SteveMayze/TfaC/images/uC-DisplayIntegrationTest.png

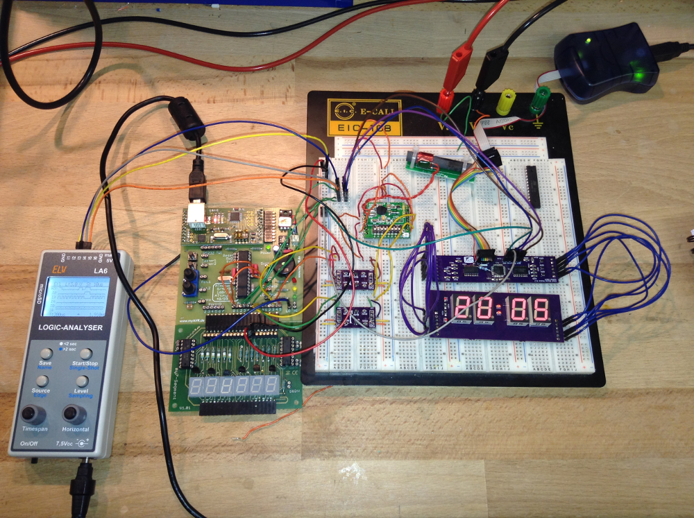
images/uC-DisplayIntegrationTest.png
