SteveMayze/TfaC/images/SystemTest-01b.JPG

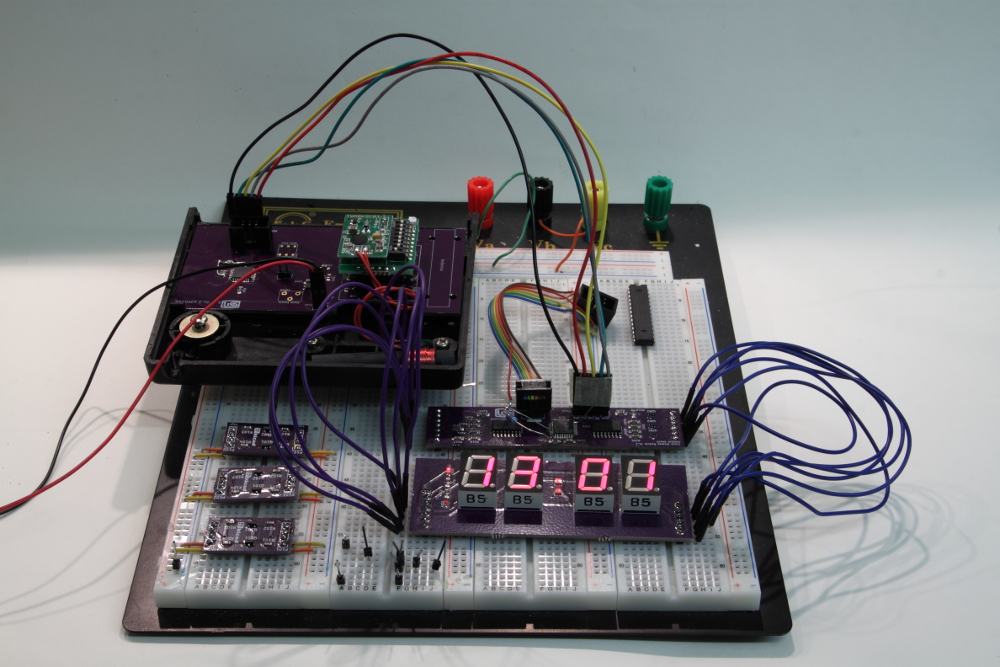
images/SystemTest-01b.JPG
