SteveMayze/TfaC/EA/image/Alarm Clock System State.png

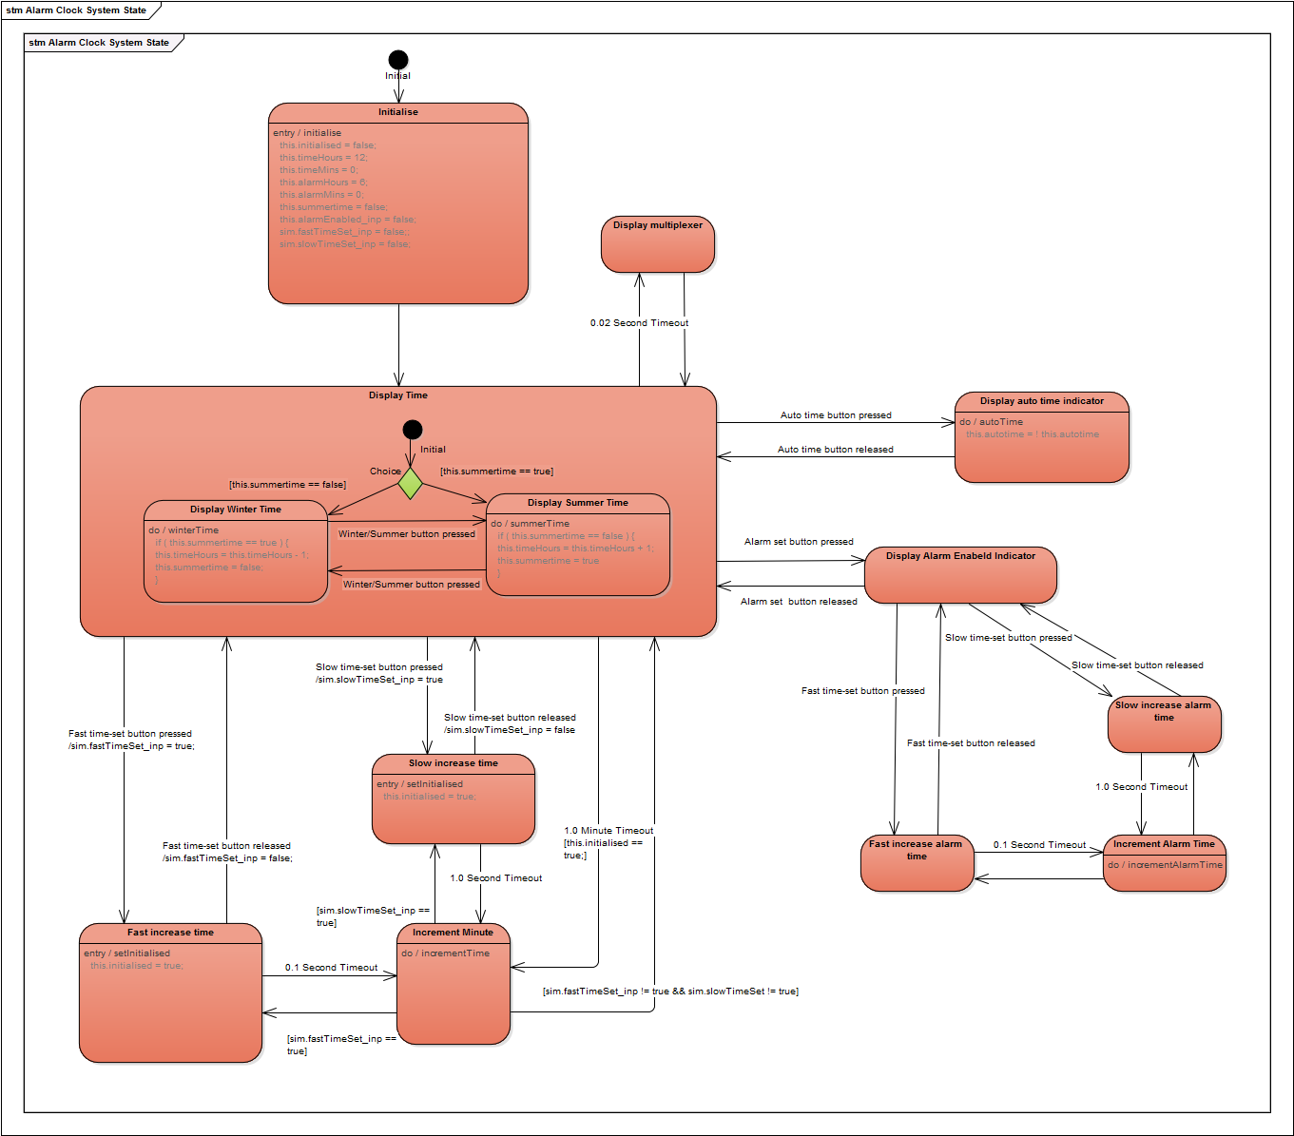
EA/image/Alarm Clock System State.png
