SteveMayze/TfaC/EA/image/Alarm Clock System.png

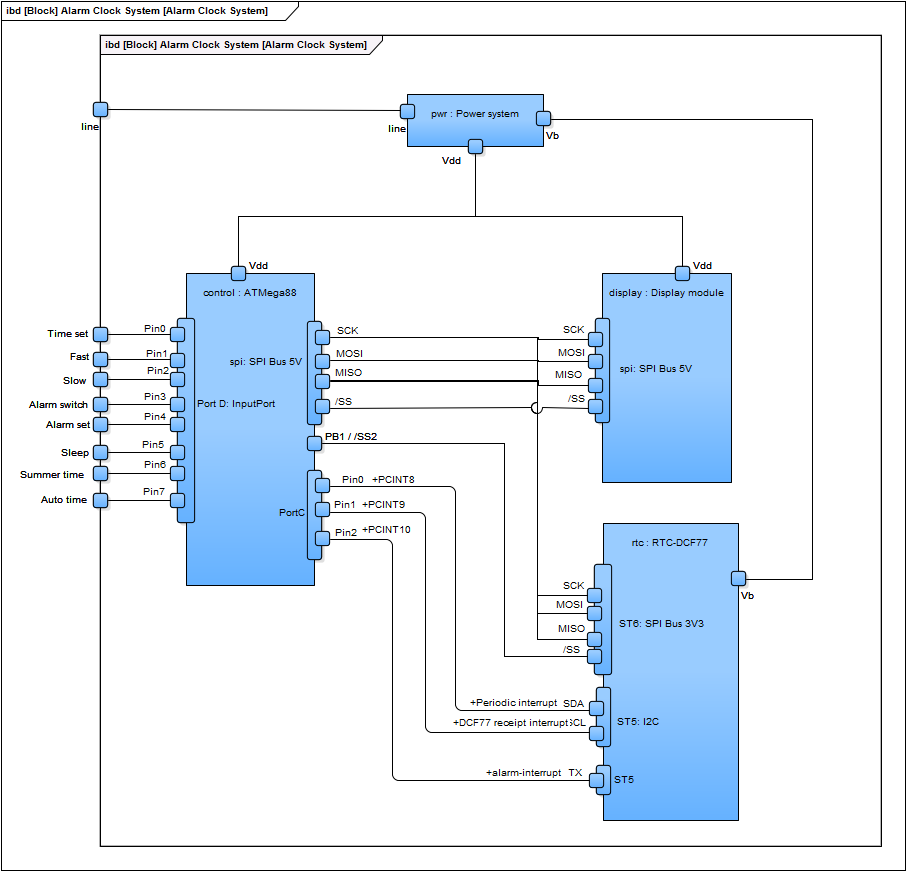
EA/image/Alarm Clock System.png
