SteveMayze/TfaC/EA/image/Display module - Controller.png

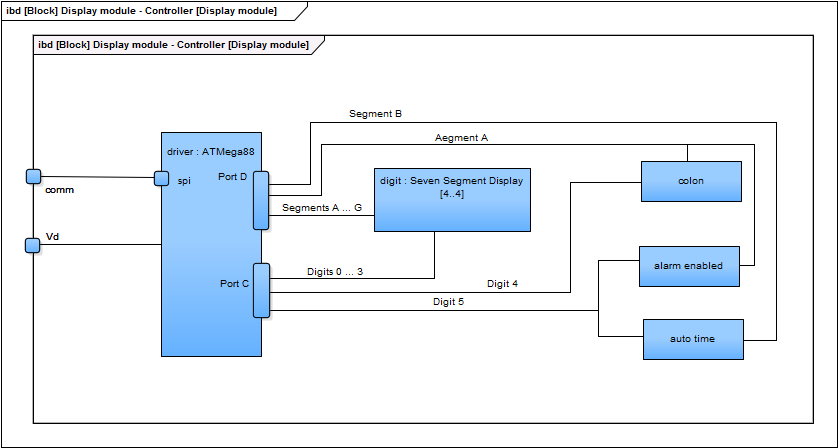
EA/image/Display module - Controller.png
