SteveMayze/TfaC/EA/image/Display module - Maxim.png

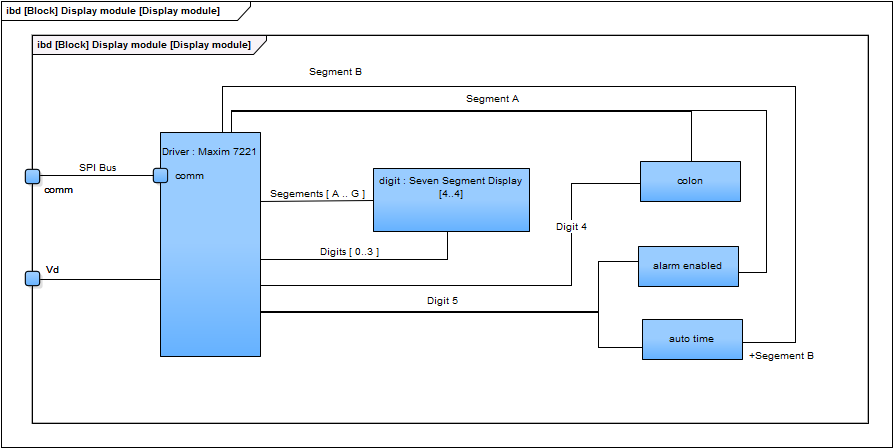
EA/image/Display module - Maxim.png
