SteveMayze/TfaC/EA/image/Project Package Model.png

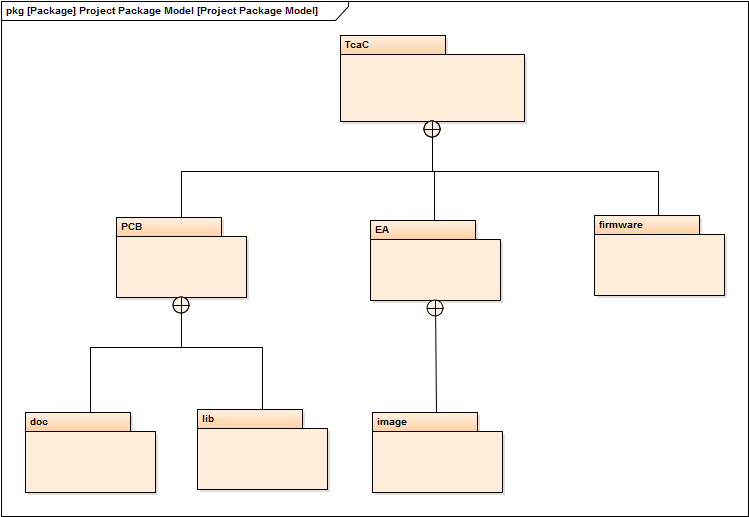
EA/image/Project Package Model.png
