SteveMayze/TfaC/EA/image/Specifications.png

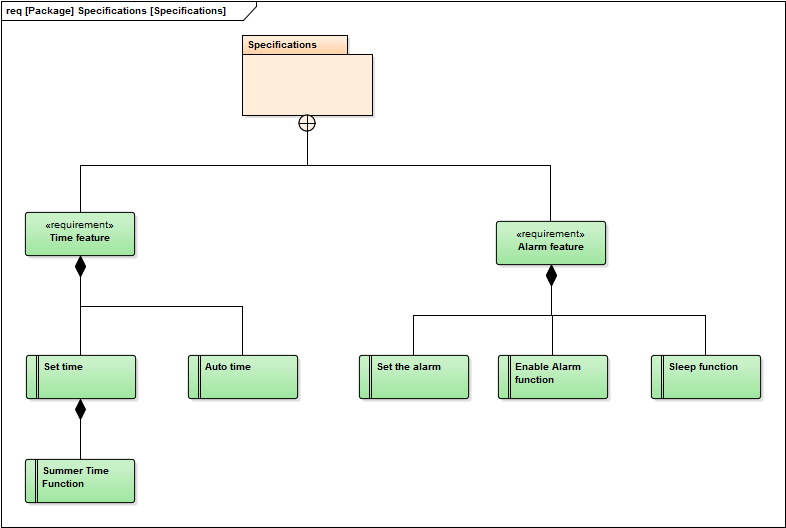
EA/image/Specifications.png
