SteveMayze/TfaC/images/ATMega88-PinOut.png

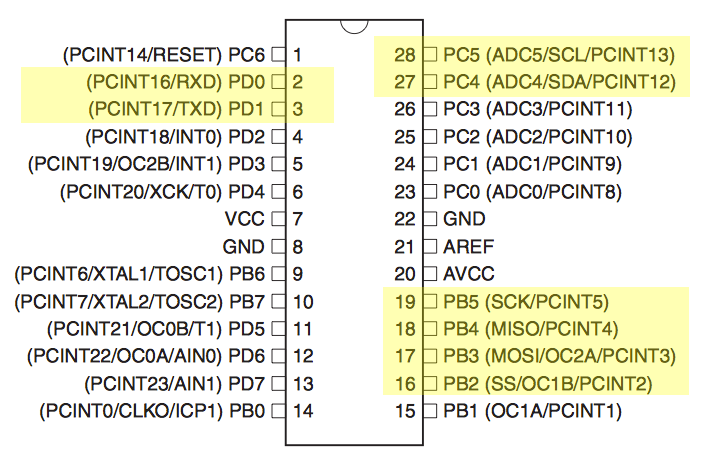
images/ATMega88-PinOut.png
