SteveMayze/TfaC/images/display-bank.png

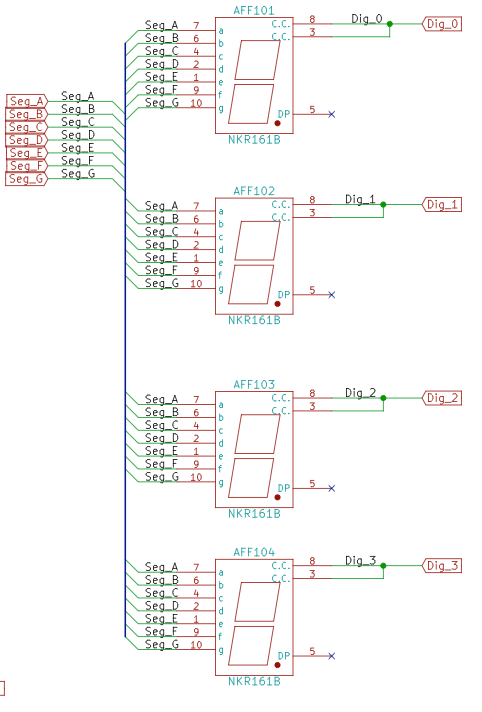
images/display-bank.png
