SteveMayze/TfaC/images/driver.png

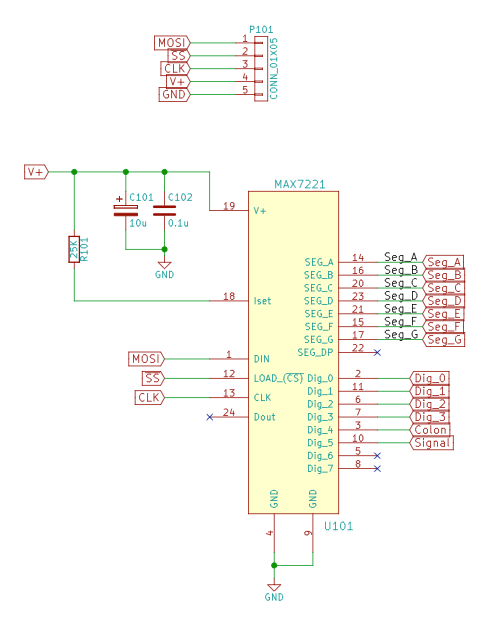
images/driver.png
