SteveMayze/TfaC/images/Heartbeat-Bodge-b.JPG

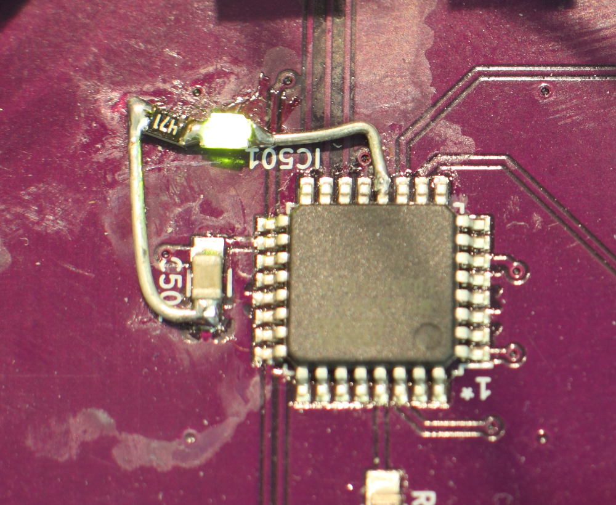
images/Heartbeat-Bodge-b.JPG
