SteveMayze/TfaC/images/indicators.png

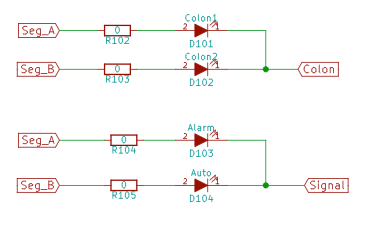
images/indicators.png
