SteveMayze/TfaC/images/Layout-4L.png

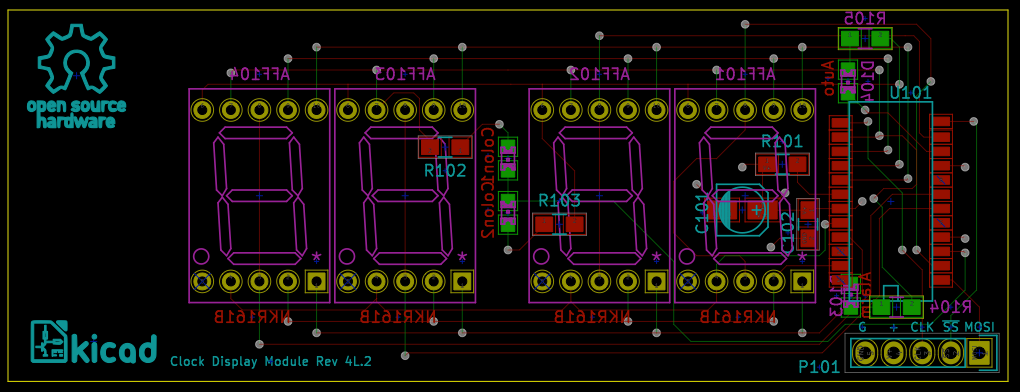
images/Layout-4L.png
