SteveMayze/TfaC/images/OHPart-Front.png

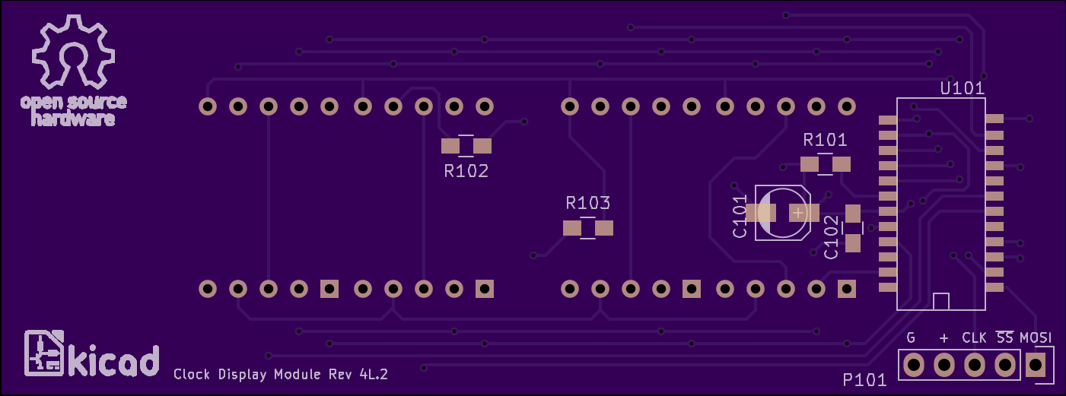
images/OHPart-Front.png
