SteveMayze/TfaC/images/OSHPark-Bottom.png

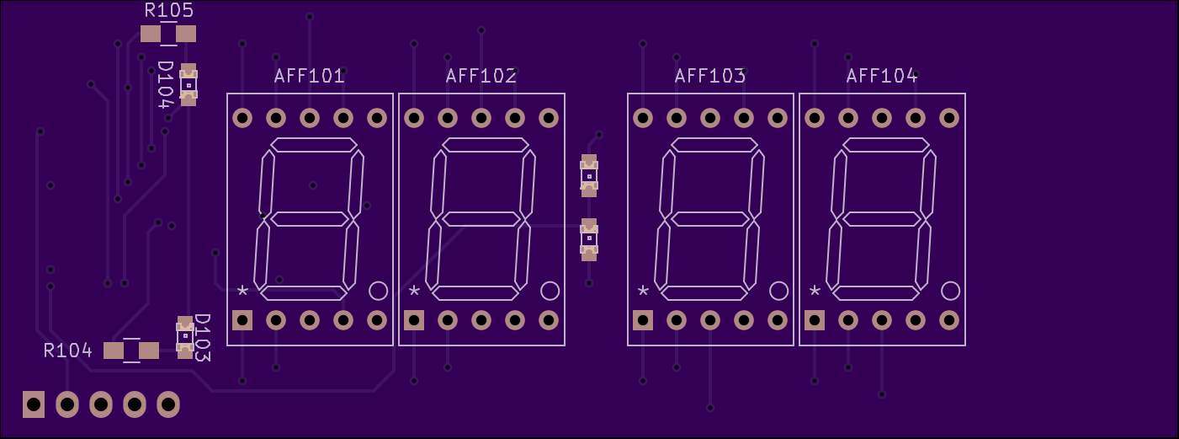
images/OSHPark-Bottom.png
