SteveMayze/TfaC/images/PanelledBoard.jpg

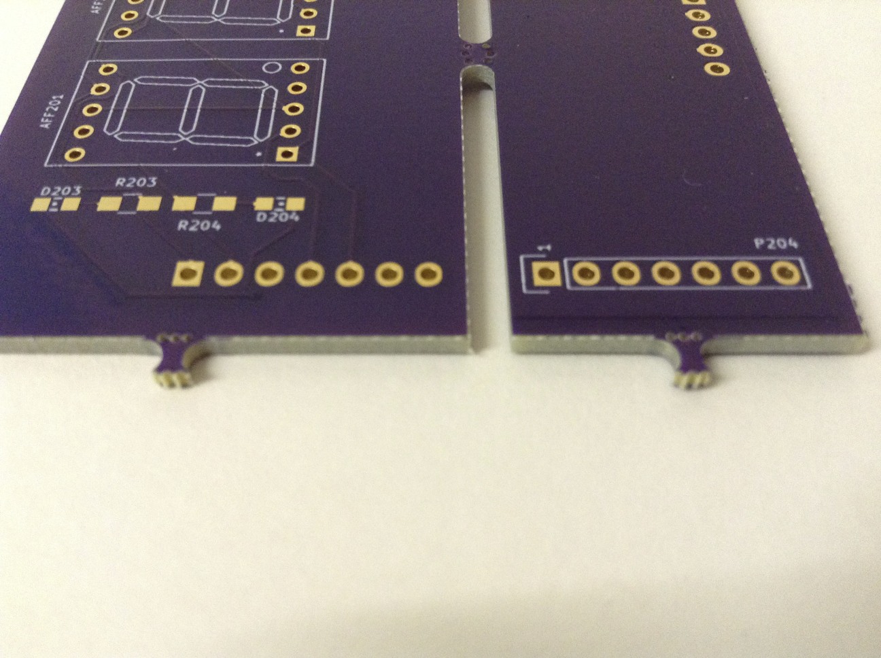
images/PanelledBoard.jpg
