SteveMayze/TfaC/images/SignalToDisplay.png

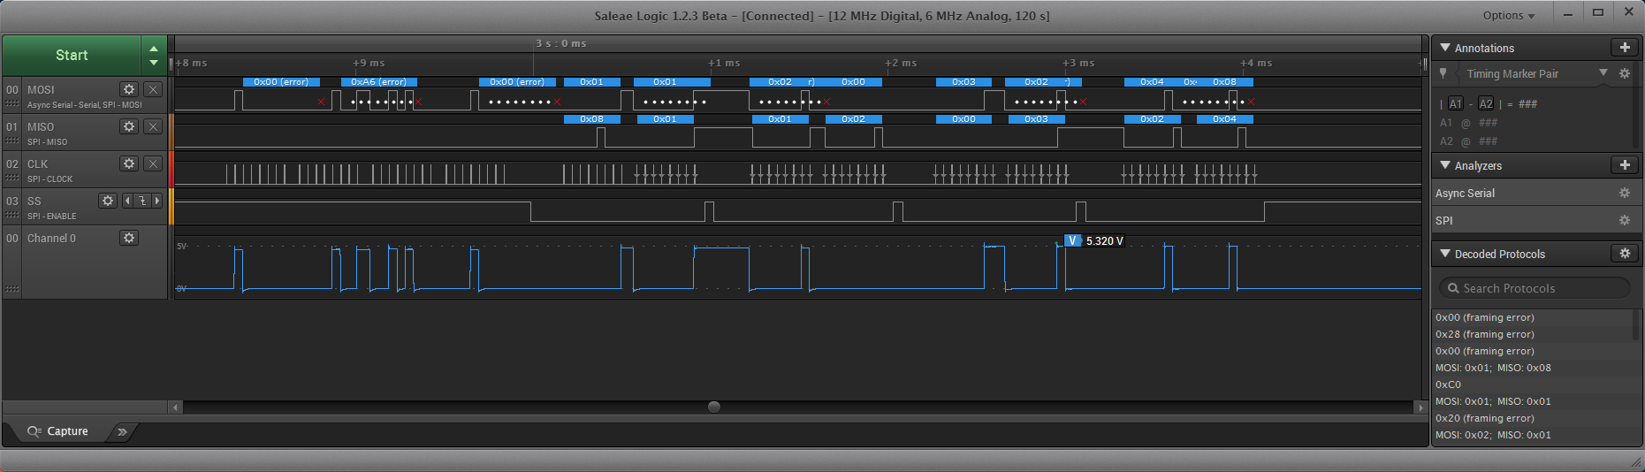
images/SignalToDisplay.png
