SteveMayze/TfaC/PCB/TfaC.ods

Sheet: Clock
Reference | Quantity | Value | Base Price | Tax | Net | Gross
C201, C202, C203, C204, | 4 | 1u | 0.03813684 | 19.00% | 0.045383 | 0.18
C501, | 1 | 100n | 0.03813684 | 19.00% | 0.045383 | 0.05
D201, D202, D501, | 3 | LED | 0.17140000 | 0.00% | 0.171400 | 0.51
D503, | 1 | 1N4148W | 0.05280000 | 19.00% | 0.062832 | 0.06
IC501, | 1 | ATMEGA88-A | 4.38000000 | 0.00% | 4.380000 | 4.38
M301, | 1 | DisplayModule | 35.13754009 | 0.00% | 35.137540 | 35.14
P101, | 1 | Line | 0.07540000 | 0.00% | 0.075400 | 0.08
P501, | 1 | PRG | 0.22620000 | 19.00% | 0.269178 | 0.27
Q401, Q402, Q403, Q404, Q405, Q406, Q408, | 7 | IRLML2502 | 0.15180000 | 19.00% | 0.180642 | 1.26
Q407, | 1 | NOPOP | 0.00000000 | 19.00% | 0.000000 | 0.00
Q501, | 1 | 2SD2391 | 0.52000000 | 19.00% | 0.618800 | 0.62
R201, | 1 | 0 | 0.02295946 | 19.00% | 0.027322 | 0.03
R202, R502, | 2 | 480Ohm | 0.02295946 | 19.00% | 0.027322 | 0.05
R203, | 1 | 260Ohm | 0.02295946 | 0.00% | 0.022959 | 0.02
R401, R403, R405, R407, R409, R411, R415, R501, | 8 | 10K | 0.02295946 | 0.00% | 0.022959 | 0.18
R402, R404, | 2 | 1K5 | 0.02295946 | 0.00% | 0.022959 | 0.05
R406, R408, R410, R412, R416, | 5 | 4K7 | 0.02295946 | 19.00% | 0.027322 | 0.14
R413, R414, | 2 | NOPOP | 0.00000000 | 0.00% | 0.000000 | 0.00
SP501, | 1 | CT-1205-SMT | 2.37000000 | 19.00% | 2.820300 | 2.82
SW501, | 1 | Time Set | 0.20800000 | 19.00% | 0.247520 | 0.25
SW502, | 1 | Alarm Set | 0.20800000 | 19.00% | 0.247520 | 0.25
SW503, | 1 | Fast | 0.20800000 | 19.00% | 0.247520 | 0.25
SW504, | 1 | Slow | 0.20800000 | 19.00% | 0.247520 | 0.25
SW505, | 1 | AUTO_TIME | 0.07540000 | 19.00% | 0.089726 | 0.09
SW506, | 1 | Sleep | 0.20800000 | 19.00% | 0.247520 | 0.25
SW507, | 1 | Summer Time | 0.07540000 | 19.00% | 0.089726 | 0.09
SW508, | 1 | Alarm Enabled | 0.82000000 | 19.00% | 0.975800 | 0.98
SW509, | 1 | Reset | 0.37700000 | 19.00% | 0.448630 | 0.45
U201, | 1 | MCP1703T-5002E/CB | 0.63000000 | 19.00% | 0.749700 | 0.75
U202, | 1 | LD2979 | 0.89000000 | 19.00% | 1.059100 | 1.06
U401, | 1 | RTC-DCF77 | 12.95000000 | 0.00% | 12.950000 | 12.95
W201, W202, | 2 | TEST_1P | 0.00000000 | 0.00% | 0.000000 | 0.00
Boards | 1 |  | 13.16000000 | 0.00% | 13.160000 | 13.16
 |  |  |  |  | COS | 76.60 €
 |  |  |  |  | Price | 229.80 €
 |  |  |  |  |  | 41.46 €

Sheet: Display
Reference | Quantity | Value | Footprint | DigiKeyPN | Base Price | Tax | Net | Gross
AFF201, AFF202, AFF203, AFF204, | 4 | NKR161B | ClockFootprints:161_163_Series_extended |  | 2.43000000 | 19.00% | 2.891700 | 11.57
C101, | 1 | 0.1u | Capacitors_SMD:C_0805 |  | 0.03813684 | 0.00% | 0.038137 | 0.04
D201, | 1 | Colon1 | LEDs:LED-0805 |  | 0.17140000 | 19.00% | 0.203966 | 0.20
D202, | 1 | Colon2 | LEDs:LED-0805 |  | 0.17140000 | 19.00% | 0.203966 | 0.20
D203, | 1 | Alarm | LEDs:LED-0805 |  | 0.17140000 | 19.00% | 0.203966 | 0.20
D204, | 1 | Auto | LEDs:LED-0805 |  | 0.17140000 | 19.00% | 0.203966 | 0.20
IC1, | 1 | ATMEGA88PA-A | Housings_QFP:LQFP-32_7x7mm_Pitch0.8mm |  | 4.38000000 | 0.00% | 4.380000 | 4.38
P101, | 1 | CONN_02X03 | Pin_Headers:Pin_Header_Straight_2x03 |  | 0.22620000 | 19.00% | 0.269178 | 0.27
P102, P202, P204, | 3 | CONN_01X07 | Pin_Headers:Pin_Header_Straight_1x07 | Value | 0.26390000 | 19.00% | 0.314041 | 0.94
P201, P203, | 2 | CONN_01X06 | Pin_Headers:Pin_Header_Straight_1x06 |  | 0.22620000 | 19.00% | 0.269178 | 0.54
Q201, Q202, Q203, | 3 | BC856BS | ClockFootprints:SOT-363 |  | 0.19640000 | 19.00% | 0.233716 | 0.70
R101, | 1 | 10K | Resistors_SMD:R_0805 |  | 0.02295946 | 0.00% | 0.022959 | 0.02
R102, R103, R104, R106, | 4 | 1K | Resistors_SMD:R_0805 |  | 0.02295946 | 0.00% | 0.022959 | 0.09
R105, R201, R202, R203, R204, | 5 | 0 | Resistors_SMD:R_0805 |  | 0.02295946 | 0.00% | 0.022959 | 0.11
R205, R206, R207, R208, R209, R210, | 6 | 500 | Resistors_SMD:R_0805 |  | 0.02295946 | 0.00% | 0.022959 | 0.14
R211, R212, R213, R214, R215, R216, R217, | 7 | 160 | Resistors_SMD:R_0805 |  | 0.02295946 | 0.00% | 0.022959 | 0.16
SW101, | 1 | TL3315NF160Q | ClockFootprints:PTS525SM15SMTR2LFS |  | 0.37700000 | 19.00% | 0.448630 | 0.45
U201, | 1 | SN74LS138 | ClockFootprints:SOIC-16 |  | 0.69600000 | 19.00% | 0.828240 | 0.83
U202, | 1 | 74HC4511 | ClockFootprints:SOIC-16 |  | 0.40700000 | 19.00% | 0.484330 | 0.48
Boards | 1 |  |  |  | 13.59666667 | 0.00% | 13.596667 | 13.60
 |  |  |  |  |  |  | COS | 35.14 €
 |  |  |  |  |  |  | Price | 105.41 €
