SteveMayze/TfaC/(list of files, cad)

Other CAD files:
Sketchup/ClockBody.skp
Sketchup/ClockBody~.skp
