SteveMayze/TfaC/Test/ClockWrong-TimeCorrect-2213-2053.png

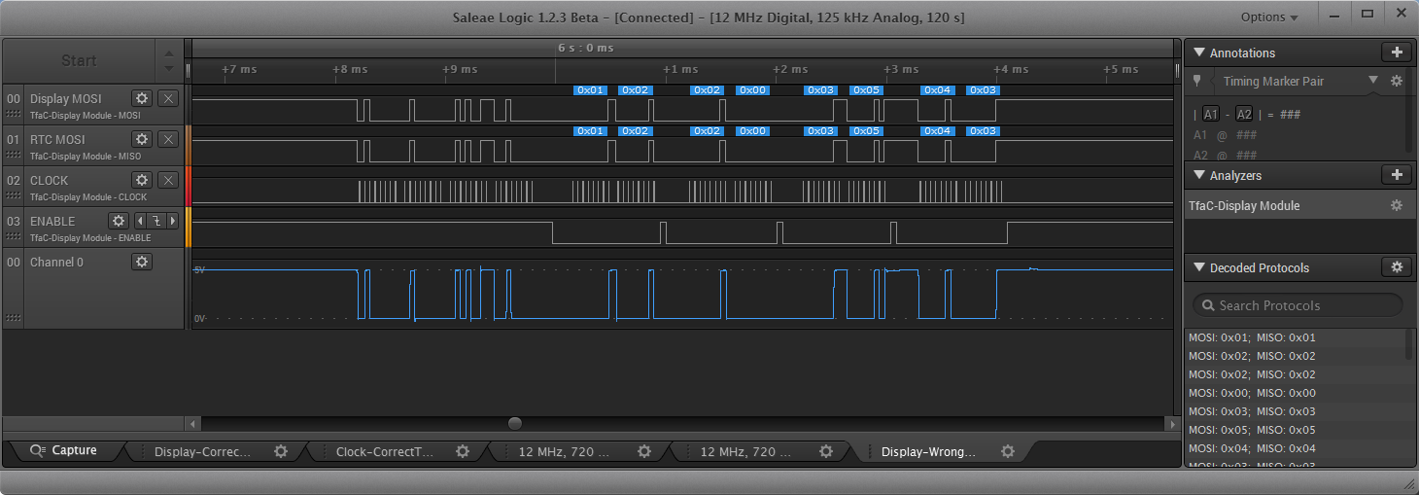
Test/ClockWrong-TimeCorrect-2213-2053.png
