SteveMayze/TfaC/Test/ClockWrong-TimeCorrect-3201-2105.png

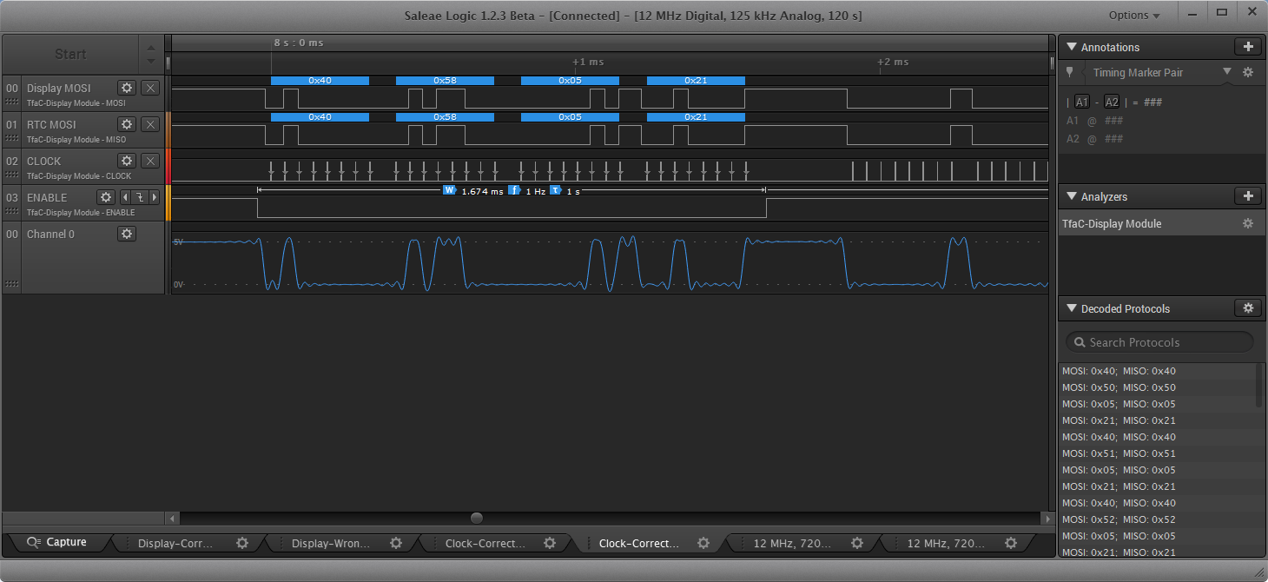
Test/ClockWrong-TimeCorrect-3201-2105.png
