SteveMayze/TfaC/Test/MOSI-Polarity-Change.png

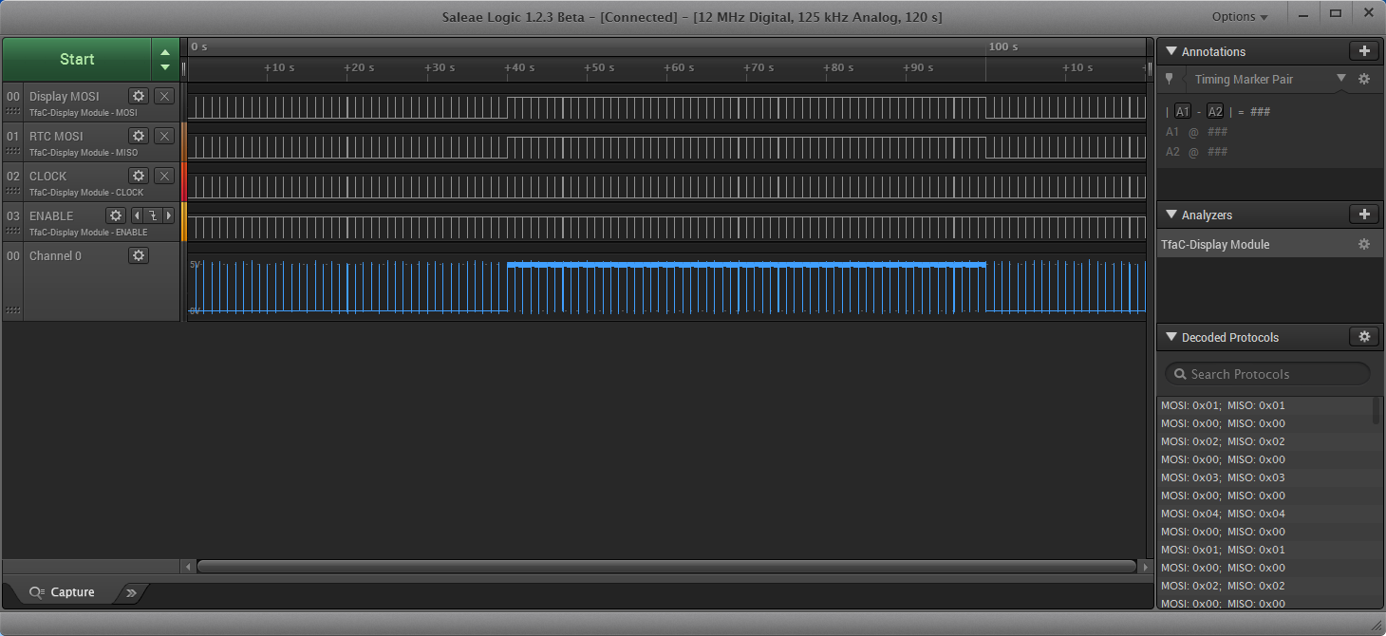
Test/MOSI-Polarity-Change.png
