SteveMayze/TfaC/PCB/spice/divider.asc

R1: res; 220
Ser: res; 110
V1: voltage; 5
Named nets: 0, Vd, Vcc
.tran 0 1 0 0.5
