SteveMayze/TfaC/PCB/TfaC.kicad_pcb

## KiCad design PCB/TfaC.kicad_pcb (2016-10-16)

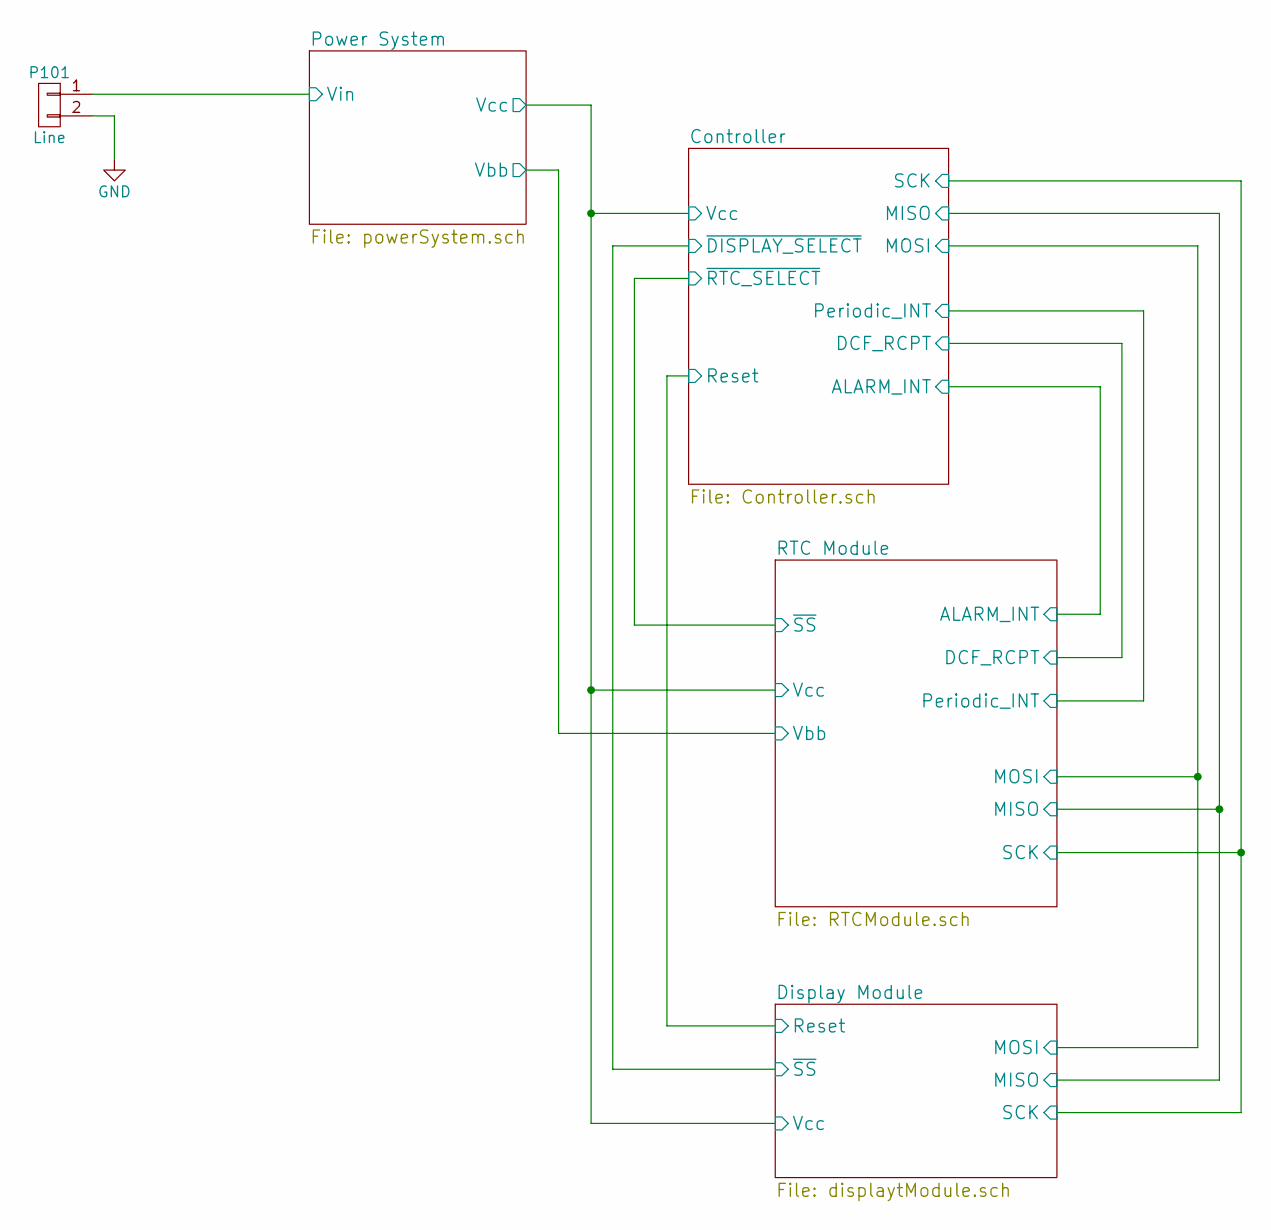
[picture p22: schematic TfaC.sch, TfaC - Arlarm Clock Restoration Project.]

Parts:
P101: Line; Pin_Header_Straight_1x02

Connections:
/Power System/Vin: P101.1; also elsewhere on the board
GND: P101.2; also elsewhere on the board

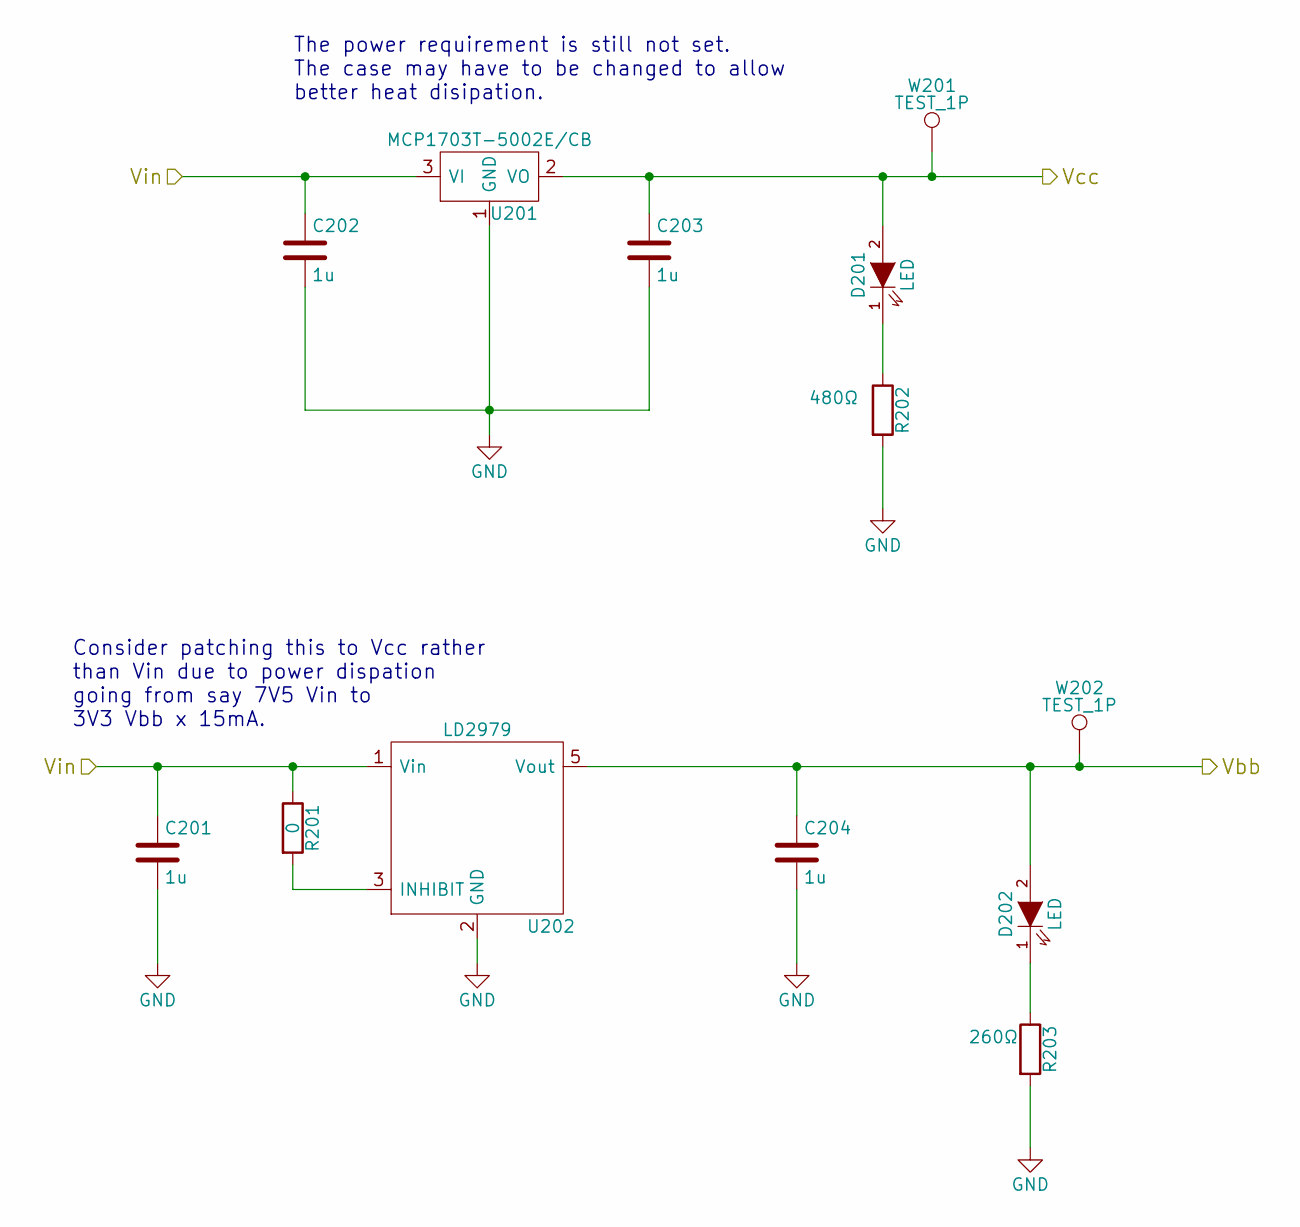
[picture p23: schematic powerSystem.sch, TfaC - Arlarm Clock Restoration Project.]

Parts:
C201, C203, C204: 1u; C_0805_HandSoldering
C202: 1u; C_0805_HandSoldering; MPN Value
D201, D202: LED; LED_0805
R201: 0; R_0805_HandSoldering
R202: 480Ω; R_0805_HandSoldering
R203: 260Ω; R_0805_HandSoldering
U201: MCP1703T-5002E/CB; SOT-23A; MPN MCP1703T-5002E/CB
U202: LD2979; SOT-23-5L
W201, W202: TEST_1P; Measurement_Point_Round-SMD-Pad_Small

Connections:
/Controller/Vcc: C203.1, D201.2 (A), U201.2 (VO), W201.1; also elsewhere on the board
/Power System/Vbb: C204.1, D202.2 (A), U202.5 (Vout), W202.1; also elsewhere on the board
/Power System/Vin: C201.1, C202.1, R201.1, U201.3 (VI), U202.1 (Vin); also elsewhere on the board
GND: C201.2, C202.2, C203.2, C204.2, R202.2, R203.2, U201.1 (GND), U202.2 (GND); also elsewhere on the board
unnamed: D201.1 (K), R202.1
unnamed: D202.1 (K), R203.1
unnamed: R201.2, U202.3 (INHIBIT)

Notes on the sheet:
Consider patching this to Vcc rather than Vin due to power dispation going from say 7V5 Vin to 3V3 Vbb x 15mA.
The power requirement is still not set. The case may have to be changed to allow better heat disipation.

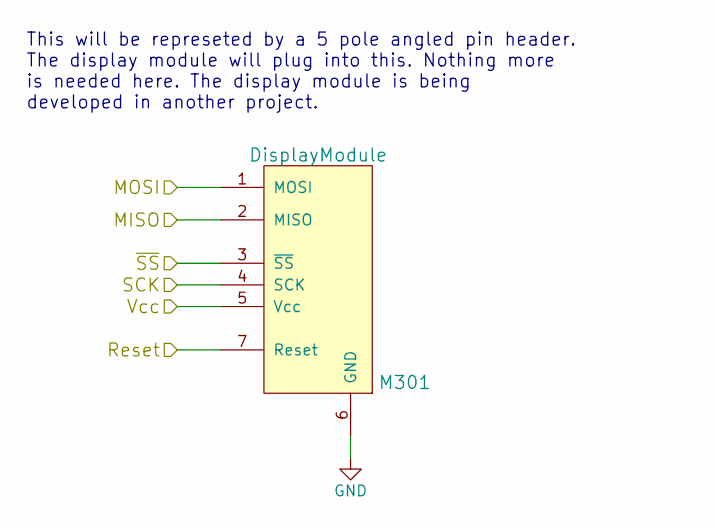
[picture p24: schematic displaytModule.sch, TfaC - Arlarm Clock Restoration Project.]

Parts:
M301: DisplayModule; Pin_Header_Straight_1x07

Connections:
/Controller/MISO: M301.2 (MISO); also elsewhere on the board
/Controller/MOSI: M301.1 (MOSI); also elsewhere on the board
/Controller/Reset: M301.7 (Reset); also elsewhere on the board
/Controller/SCK: M301.4 (SCK); also elsewhere on the board
/Controller/Vcc: M301.5 (Vcc); also elsewhere on the board
/Controller/~DISPLAY_SELECT: M301.3 (~SS); also elsewhere on the board
GND: M301.6 (GND); also elsewhere on the board

Notes on the sheet:
This will be represeted by a 5 pole angled pin header. The display module will plug into this. Nothing more is needed here. The display module is being developed in another project.

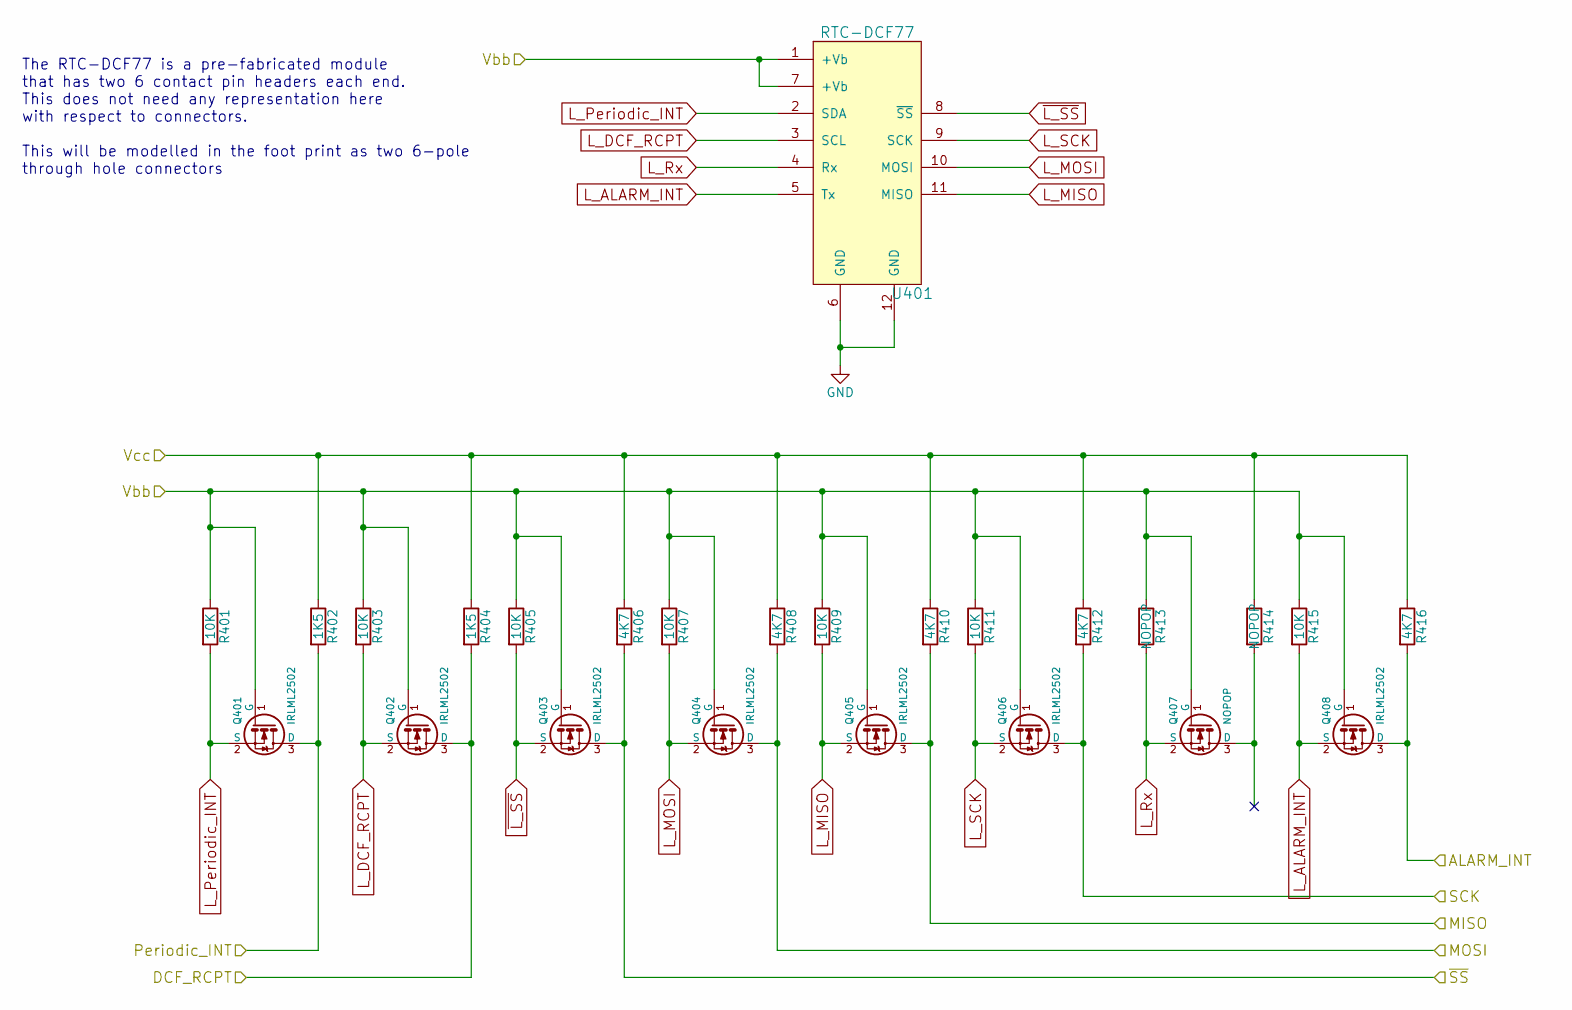
[picture p25: schematic RTCModule.sch, TfaC - Arlarm Clock Restoration Project.]

Parts:
Q401, Q402, Q403, Q404, Q405, Q406, Q408: IRLML2502; Micro3
Q407: NOPOP; Micro3
R401, R403, R405, R407, R409, R411, R415: 10K; R_0805_HandSoldering
R402, R404: 1K5; R_0805_HandSoldering
R406, R408, R410, R412, R416: 4K7; R_0805_HandSoldering
R413, R414: NOPOP; R_0805_HandSoldering
U401: RTC-DCF77; RTC-DCF

Connections:
/Controller/ALARM_INT: Q408.3 (D), R416.2; also elsewhere on the board
/Controller/DCF_RCPT: Q402.3 (D), R404.2; also elsewhere on the board
/Controller/MISO: Q405.3 (D), R410.2; also elsewhere on the board
/Controller/MOSI: Q404.3 (D), R408.2; also elsewhere on the board
/Controller/Periodic_INT: Q401.3 (D), R402.2; also elsewhere on the board
/Controller/SCK: Q406.3 (D), R412.2; also elsewhere on the board
/Controller/Vcc: R402.1, R404.1, R406.1, R408.1, R410.1, R412.1, R414.1, R416.1; also elsewhere on the board
/Controller/~RTC_SELECT: Q403.3 (D), R406.2; also elsewhere on the board
/Power System/Vbb: Q401.1 (G), Q402.1 (G), Q403.1 (G), Q404.1 (G), Q405.1 (G), Q406.1 (G), Q407.1 (G), Q408.1 (G), R401.1, R403.1, R405.1, R407.1, R409.1, R411.1, R413.1, R415.1, U401.1 (+Vb), U401.7 (+Vb); also elsewhere on the board
GND: U401.6 (GND), U401.12 (GND); also elsewhere on the board
L_ALARM_INT: Q408.2 (S), R415.2, U401.5 (Tx)
L_DCF_RCPT: Q402.2 (S), R403.2, U401.3 (SCL)
L_MISO: Q405.2 (S), R409.2, U401.11 (MISO)
L_MOSI: Q404.2 (S), R407.2, U401.10 (MOSI)
L_Periodic_INT: Q401.2 (S), R401.2, U401.2 (SDA)
L_Rx: Q407.2 (S), R413.2, U401.4 (Rx)
L_SCK: Q406.2 (S), R411.2, U401.9 (SCK)
unnamed: Q407.3 (D), R414.2
~L_SS: Q403.2 (S), R405.2, U401.8 (~SS)

Notes on the sheet:
The RTC-DCF77 is a pre-fabricated module that has two 6 contact pin headers each end. This does not need any representation here with respect to connectors. This will be modelled in the foot print as two 6-pole through hole connectors

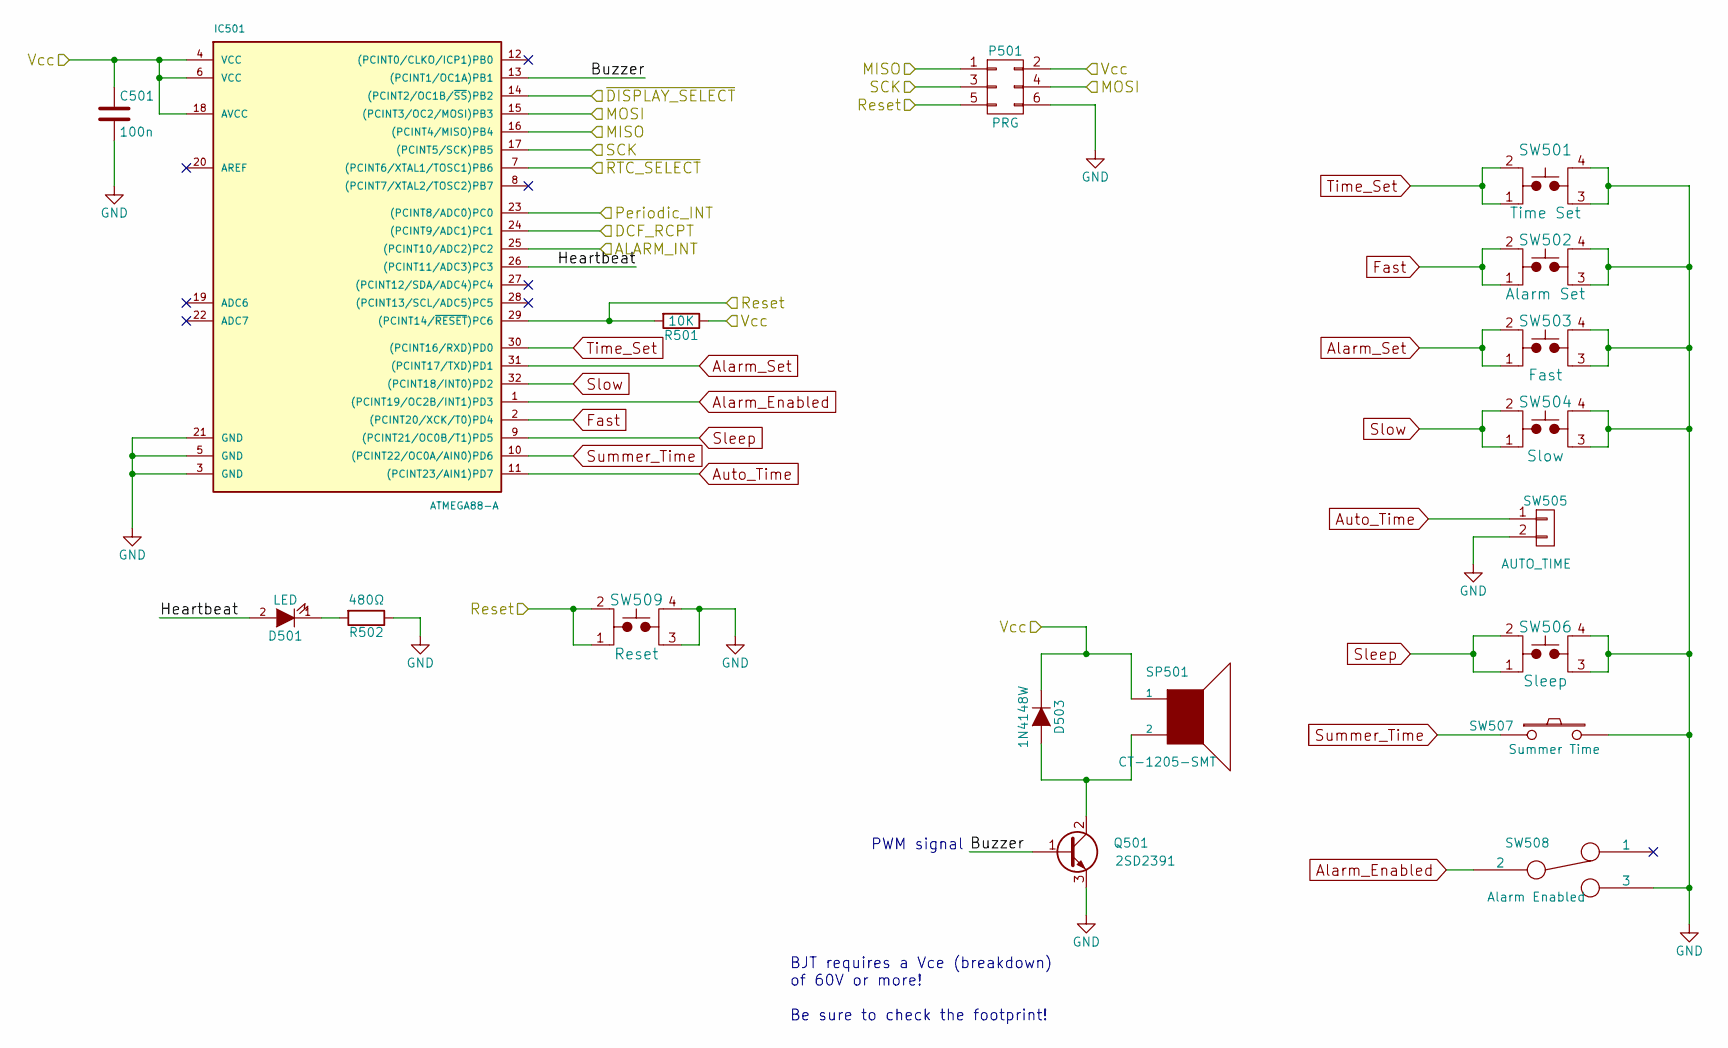
[picture p26: schematic Controller.sch, TfaC - Arlarm Clock Restoration Project.]

Parts:
C501: 100n; C_0805_HandSoldering
D501: LED; LED_0805; Voltage Value; DigiKeyPN Value
D503: 1N4148W; SOD-123; Voltage Value; DigiKeyPN Value
IC501: ATMEGA88-A; LQFP-32_7x7mm_Pitch0.8mm
P501: PRG; Pin_Header_Straight_2x03
Q501: 2SD2391; SOT89-3_Housing; Voltage Value; DigiKeyPN Value
R501: 10K; R_0805_HandSoldering
R502: 480Ω; R_0805_HandSoldering
SP501: CT-1205-SMT; Voltage Value; DigiKeyPN 102-1199-2-ND
SW501: Time Set; TL3315; MPN Value
SW502: Alarm Set; TL3315
SW503: Fast; TL3315
SW504: Slow; TL3315
SW505: AUTO_TIME; Pin_Header_Straight_1x02
SW506: Sleep; TL3315
SW507: Summer Time; Pin_Header_Straight_1x02
SW508: Alarm Enabled; CLSB12C01
SW509: Reset; PTS525SM15SMTR2LFS

Connections:
/Controller/ALARM_INT: IC501.25 ((PCINT10/ADC2)PC2); also elsewhere on the board
/Controller/Buzzer: IC501.13 ((PCINT1/OC1A)PB1), Q501.1 (B)
/Controller/DCF_RCPT: IC501.24 ((PCINT9/ADC1)PC1); also elsewhere on the board
/Controller/Heartbeat: D501.2 (A), IC501.26 ((PCINT11/ADC3)PC3)
/Controller/MISO: IC501.16 ((PCINT4/MISO)PB4), P501.1; also elsewhere on the board
/Controller/MOSI: IC501.15 ((PCINT3/OC2/MOSI)PB3), P501.4; also elsewhere on the board
/Controller/Periodic_INT: IC501.23 ((PCINT8/ADC0)PC0); also elsewhere on the board
/Controller/Reset: IC501.29 ((PCINT14/~RESET~)PC6), P501.5, R501.2, SW509.1, SW509.2; also elsewhere on the board
/Controller/SCK: IC501.17 ((PCINT5/SCK)PB5), P501.3; also elsewhere on the board
/Controller/Vcc: C501.1, D503.1 (K), IC501.4 (VCC), IC501.6 (VCC), IC501.18 (AVCC), P501.2, R501.1, SP501.1; also elsewhere on the board
/Controller/~DISPLAY_SELECT: IC501.14 ((PCINT2/OC1B/~SS~)PB2); also elsewhere on the board
/Controller/~RTC_SELECT: IC501.7 ((PCINT6/XTAL1/TOSC1)PB6); also elsewhere on the board
Alarm_Enabled: IC501.1 ((PCINT19/OC2B/INT1)PD3), SW508.2
Alarm_Set: IC501.31 ((PCINT17/TXD)PD1), SW503.1, SW503.2
Auto_Time: IC501.11 ((PCINT23/AIN1)PD7), SW505.1
Fast: IC501.2 ((PCINT20/XCK/T0)PD4), SW502.1, SW502.2
GND: C501.2, IC501.3 (GND), IC501.5 (GND), IC501.21 (GND), P501.6, Q501.3 (E), R502.1, SW501.3, SW501.4, SW502.3, SW502.4, SW503.3, SW503.4, SW504.3, SW504.4, SW505.2, SW506.3, SW506.4, SW507.2, SW508.3, SW509.3, SW509.4; also elsewhere on the board
unnamed: D501.1 (K), R502.2
unnamed: D503.2 (A), Q501.2 (C), SP501.2
Sleep: IC501.9 ((PCINT21/OC0B/T1)PD5), SW506.1, SW506.2
Slow: IC501.32 ((PCINT18/INT0)PD2), SW504.1, SW504.2
Summer_Time: IC501.10 ((PCINT22/OC0A/AIN0)PD6), SW507.1
Time_Set: IC501.30 ((PCINT16/RXD)PD0), SW501.1, SW501.2

Notes on the sheet:
BJT requires a Vce (breakdown) of 60V or more! Be sure to check the footprint!
PWM signal

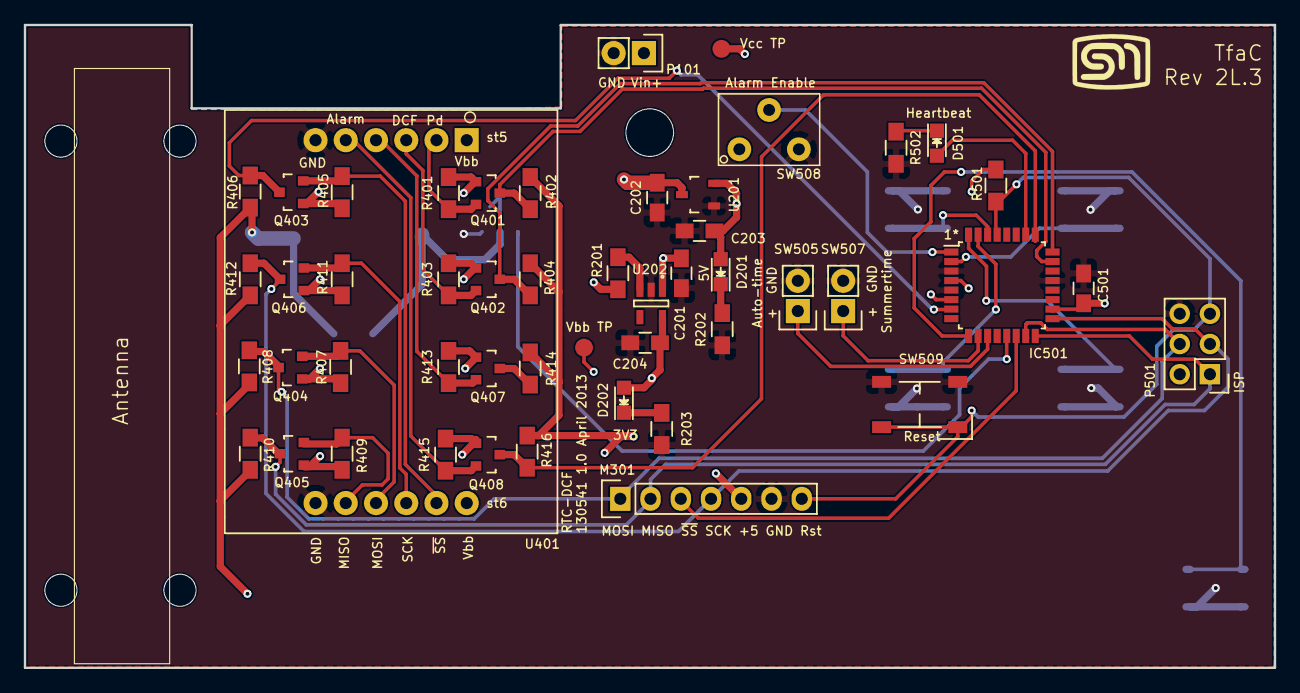
[picture p27: board TfaC.kicad_pcb from above]

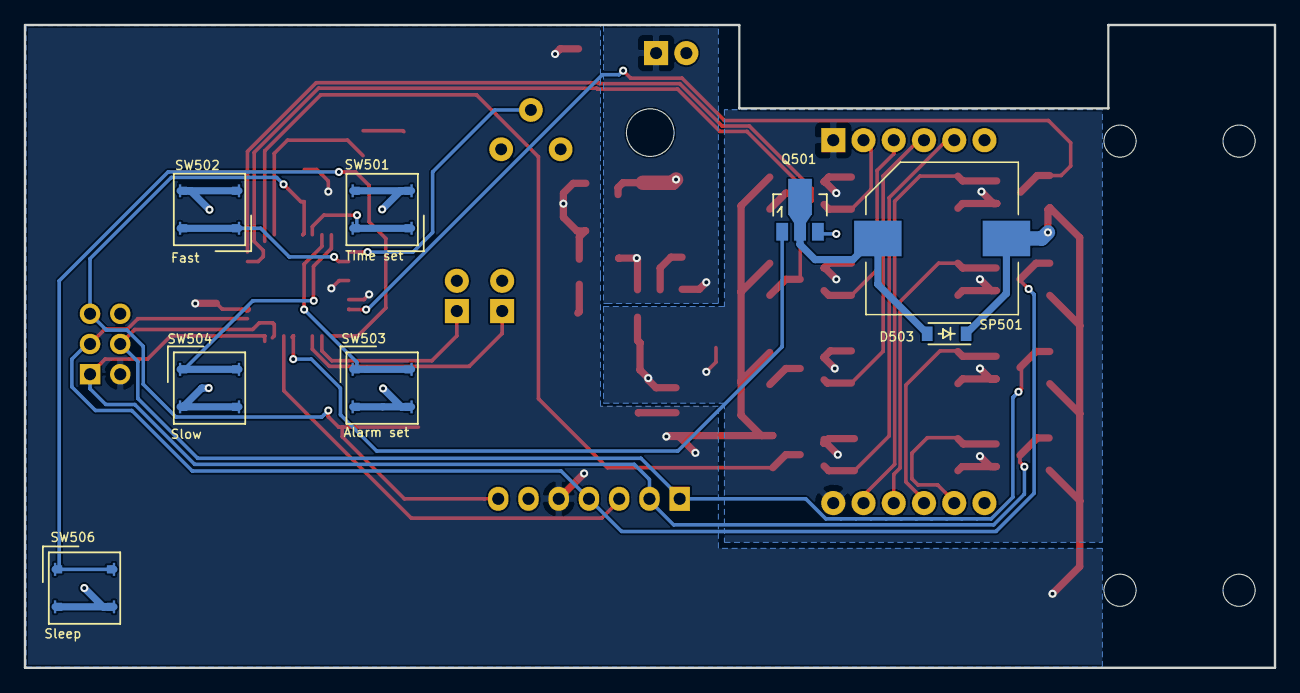
[picture p28: board TfaC.kicad_pcb from below]

Board: 2 copper layers, 105.0 x 54.0 mm, 59 parts (8 on the bottom side), 37 nets.

Other parts of the board:
MNT1: MountingHole_4mm
