SteveMayze/TfaC/(commit log)

2015-05-23 Initial checkin of the kicad schematic hierachry
    [Controller.sch, RTCModule.sch, TfaC.sch, displaytModule.sch, powerSystem.sch]
2015-05-27 Started the schematic. Added the power circuit
    [Controller.sch, RTCModule.sch, TfaC.sch, displaytModule.sch, powerSystem.sch]
2015-06-01 Corrected symbol for the LD2979 and filtering capacitors
    [RTCModule.sch, displaytModule.sch, powerSystem.sch]
2015-06-01 Added spice model to explore the use of a voltage divider
2015-06-04 Updated the schematic for the RTC and controller
    [Controller.sch, RTCModule.sch, TfaC.sch, displaytModule.sch]
2015-06-06 Updated the main block diagram
    New findings during the schematic have been updated into the SysML
    model.
2015-07-04 Added the symbol for the display module, which will actually be just a pin header
    [displaytModule.sch]
2015-07-12 correction to the reset circuit
    [Controller.sch, RTCModule.sch, TfaC.sch, displaytModule.sch, powerSystem.sch]
2015-07-12 Initial main board PCB outline
    [TfaC.kicad_pcb]
2015-08-04 Generated the Netlist and started associating footprints
    [Controller.sch, RTCModule.sch, TfaC.kicad_pcb, TfaC.sch, displaytModule.sch, powerSystem.sch]
2015-08-04 Updated some docs for switches
    [ClockBody.skp, ClockBody~.skp]
2015-08-16 Added the tactile switch
    [Controller.sch]
2015-08-16 Added the switch footprints and started the layout
    [Controller.sch, RTCModule.sch, TfaC.kicad_pcb, powerSystem.sch]
2015-08-19 Started the layout
    [Controller.sch, RTCModule.sch, TfaC.kicad_pcb, TfaC.sch, displaytModule.sch, powerSystem.sch]
2015-08-23 Getting up to date
    [CLOCKCONTROLLER.CFG, Controller.sch, DISPLAYTEST.CFG, RTCModule.sch, TfaC.sch, displaytModule.sch, powerSystem.sch]
2015-09-08 Added a couple of images to document the progress (for the display module)
2015-09-10 Added isolation resistors and corrected the reset connection
    [Controller.sch, RTCModule.sch, TfaC.sch, displaytModule.sch, powerSystem.sch]
2015-09-10 Corrected isolation resistor from 4.7k to 1k
    [Controller.sch, RTCModule.sch, TfaC.sch, displaytModule.sch, powerSystem.sch]
2015-09-20 Trying out an alternative layout
    [Controller.sch, RTCModule.sch, TfaC.kicad_pcb, TfaC.sch, displaytModule.sch, powerSystem.sch]
2015-09-22 Completed draft layout for the alternate layout
    [RTCModule.sch, TfaC.kicad_pcb, TfaC.sch]
2015-09-22 Completed the layout and generated the Gerbers
    [TfaC-B_Cu.gbl, TfaC-B_Mask.gbs, TfaC-B_Paste.gbp, TfaC-B_SilkS.gbo, TfaC-Edge_Cuts.gko, TfaC-F_Cu.gtl, TfaC-F_Mask.gts, TfaC-F_Paste.gtp]
2015-10-13 2L.2 board corrections
    [TfaC.kicad_pcb]
2015-10-27 Made corrections to the board for rev 2L.2
    [Controller.sch, RTCModule.sch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]
2015-10-27 Touched up some routs to avoid zone borders
    [TfaC.kicad_pcb]
2015-10-27 Created gerbers for TfaC-Rev 2L.2.a2f0245
    [TfaC-B_Cu.gbl, TfaC-B_Mask.gbs, TfaC-B_Paste.gbp, TfaC-B_SilkS.gbo, TfaC-Edge_Cuts.gko, TfaC-F_Cu.gtl, TfaC-F_Mask.gts, TfaC-F_Paste.gtp]
2015-10-27 Started on the main board firmware
    [FIRMWARE_01.CFG]
2015-11-06 small changes
    [Controller.sch, RTCModule.sch, TfaC.sch, displaytModule.sch, powerSystem.sch]
2015-11-19 Added indicator LEDs and Heartbeat
    [Controller.sch, RTCModule.sch, TfaC.kicad_pcb, TfaC.sch, displaytModule.sch, powerSystem.sch]
2015-11-19 Created a prototype firmware for SPI using MyAVR
    [FIRMWARE_PROTOTYPE.CFG]
2015-11-29 Updted the prototype firmware for further testing
2015-12-03 Updated the firmware to work with SPI RTC and display
2015-12-03 Updated the board for further features to the display
    [Controller.sch, TfaC.kicad_pcb, TfaC.sch, displaytModule.sch]
2015-12-03 Updated revision number
    [TfaC.kicad_pcb]
2015-12-10 Working model of the firmware using the micro based display
    [FIRMWARE_REV1.CFG]
2015-12-12 Removed the kicad cache from the .gitignore
2015-12-12 Corrected the symbol and footprint for the reset switch
    [Controller.sch, RTCModule.sch, TfaC.kicad_pcb, TfaC.sch, displaytModule.sch, powerSystem.sch]
2015-12-12 Added the missing track for the reset switch with the new foot print
    [TfaC.kicad_pcb]
2015-12-13 Disabled the interrupts when accessing the SPI
2015-12-31 An intermediate save of code that is basically working
    [FIRMWARE_MAXIM_REV1.CFG, logic-clockOutput.csv, logic-displayInput-long.csv]
2015-12-31 Removed the csv files... to big
    [logic-clockOutput.csv, logic-displayInput-long.csv]
2016-01-03 firmware/firmware_rev1.bas that works with a high percent of precision 0.03% failure
    [firmware_rev1.bas]
2016-01-16 Updated the model to bring it in line with the current state of the prototype findings
2016-01-24 Added stress test to check the display
    [STRESSTEST1.CFG]
2016-01-30 Updated the block diagram with the Port C PCINT
    Port C is going to be used for the UI i.e. the control switches for the
    alarm clock such as alarm set, time set etc. The block diagram was
    updated to highlight the PCINT numbers for the input pins.
2016-02-09 A new stress test
    [FIRMWARE_REV2.CFG, STRESSTEST2.CFG]
2016-02-09 Added button handling for setting the alarm values
    Corrected the issue where the fast-set and alarm-set buttons are
    swapped!
    [Controller.sch, RTCModule.sch, TfaC.sch, displaytModule.sch, powerSystem.sch]
2016-02-16 Added rev3 of the firmware for the alarm
    [FIRMWARE_REV3.CFG]
2016-03-08 Updated the routing to comply with the display module
    [TfaC.kicad_pcb, displaytModule.sch]
2016-03-08 Shifted the ISP to a more sensible location
    [TfaC.kicad_pcb]
2016-03-09 Cleaned up some more routes
    [TfaC.kicad_pcb]
2016-04-25 Added alarm
    [Controller.sch, TfaC.kicad_pcb, powerSystem.sch]
2016-05-10 Created firmware_rev4 to use one of the indicators as the DCF Received lamp
    [FIRMWARE_REV4.CFG]
2016-05-10 stopped using the indicator on the main board and only on the display for the DFC signal received
2016-07-28 Re-organised the board to incorporate the MISO
    [Controller.sch, TfaC.kicad_pcb, displaytModule.sch, powerSystem.sch]
2016-07-31 Revision 2L_3 Gerbers and sent to OSHPark
    [TfaC-B.Cu.GBL, TfaC-B.Mask.GBS, TfaC-B.Paste.GBP, TfaC-B.SilkS.GBO, TfaC-B_Cu.gbl, TfaC-Edge.Cuts.GKO, TfaC-F.Cu.GTL, TfaC-F.Mask.GTS]
2016-09-01 Updated the heartbeat output in preperation for the buzzer
    [firmware_rev4.bas]
2016-10-11 Firmware_rev5: Able to get the alarm to fire by reading the status register
    [FIRMWARE_REV5.CFG, UNDERSTANDINGPWM.CFG]
2016-10-12 firmware_rev6: Cleaned up the operation and the alarm enable feature
    [FIRMWARE_REV6.CFG]
2016-10-13 firmware_rev7: delay for main board start up to give time for the display
    [FIRMWARE_REV7.CFG]
2016-10-13 firmware_rev7: improved the performance of the alarm setting buttons
2016-10-15 firmware_rev7: Fixed the initial time when the alarm is disabled
    [firmware_rev7.bas]
2016-10-15 firmware_rev7: fixed alarm not ending correctly
    [BuzzerTest.bas, firmware_rev7.bas]
2016-10-16 Started BOM analysis
    [TfaC.csv]
2016-10-16 Added diagram notes
    [Controller.sch, RTCModule.sch, TfaC.sch, displaytModule.sch, powerSystem.sch]
2016-10-16 re-created the BOM for analysis
    [TfaC.ods]
2016-10-16 firmware_rev7 comment changes
    [TfaC.ods]
2016-10-16 Updated the BOM for the cust analysis
    [TfaC.ods]
2016-10-16 BOM Added the cost of the boards
    [TfaC.ods]
2017-10-21 Updates to the alarm handling
    [UNDERSTANDINGPWM.CFG]
